np-webdev/Plant-Watering-System/README.md

# Plant-Watering-System

## Pflanzen Bewässerungssystem für 5 Pflanzen

| Arduino, Relaiskarte und Überlaufsensor YL69 |
|-|
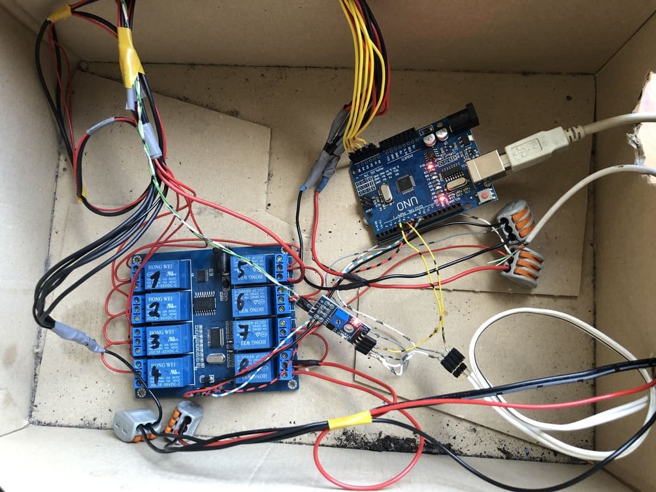
[picture p1: img/1._Arduino,_Relaiskarte_und_Sensor YL69.jpg]
|  |

| Feuchtigkeitssensoren | | | |
|-|-|-|-|
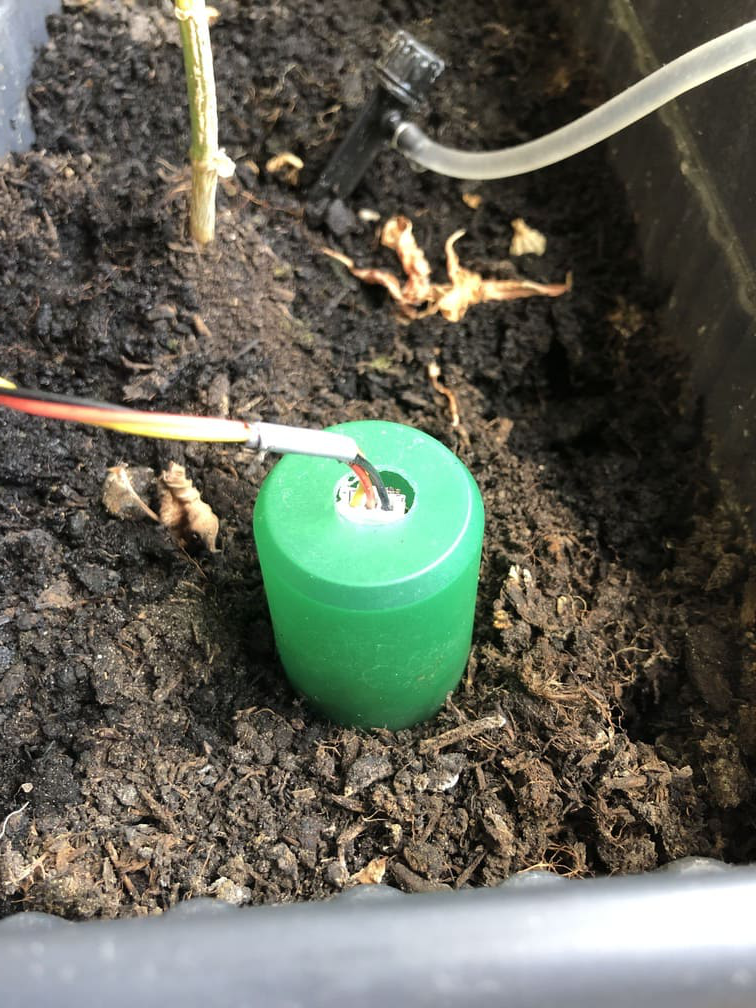
[picture p2: img/2._Feuchtigkeitssensor_verdeckt.jpg]
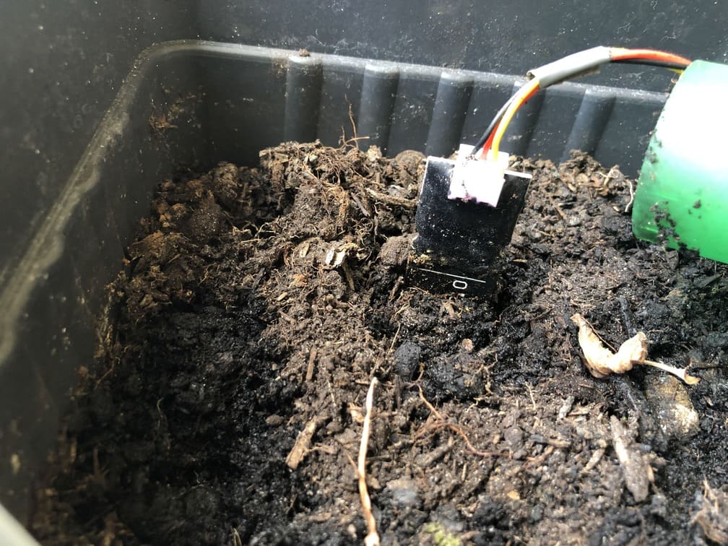
[picture p3: img/3._Feuchtigkeitssensor_mit_heißkleber.jpg]
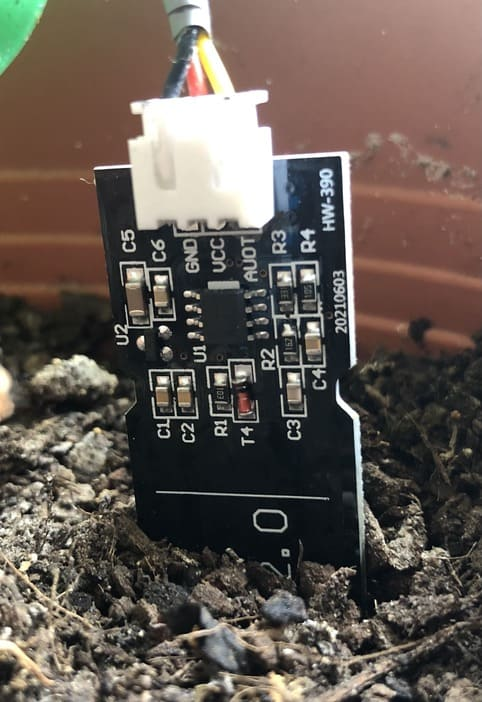
[picture p4: img/3._Feuchtigkeitssensor_neu.jpg]
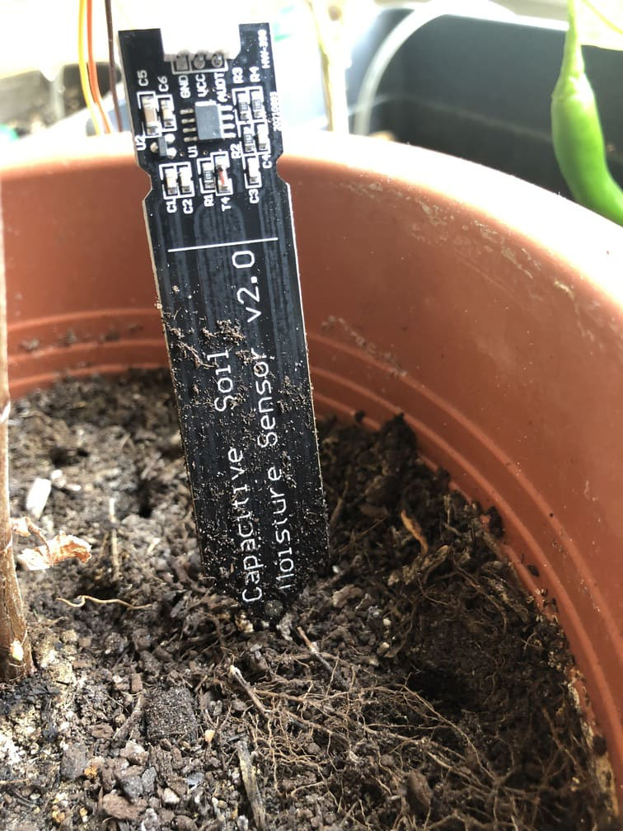
[picture p5: img/3._Feuchtigkeitssensor_neu_komplett.jpg]
|  |  |  |  |

| Pumpe und Schwimmerschalter | Wassertank |
|-|-|
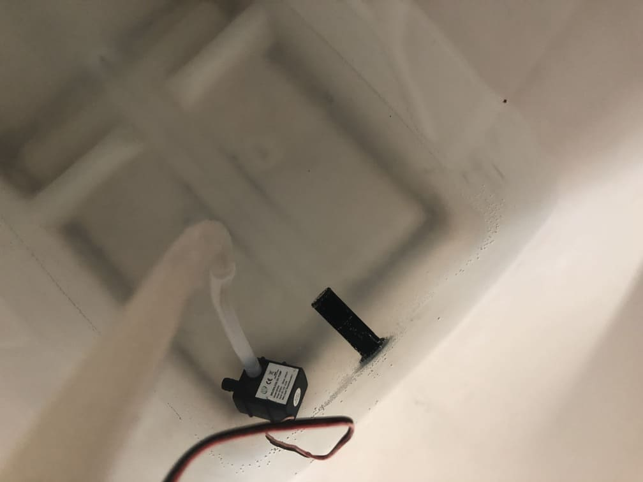
[picture p6: img/4._Tank,_Pumpe,_Schwimmerschalter.jpg]
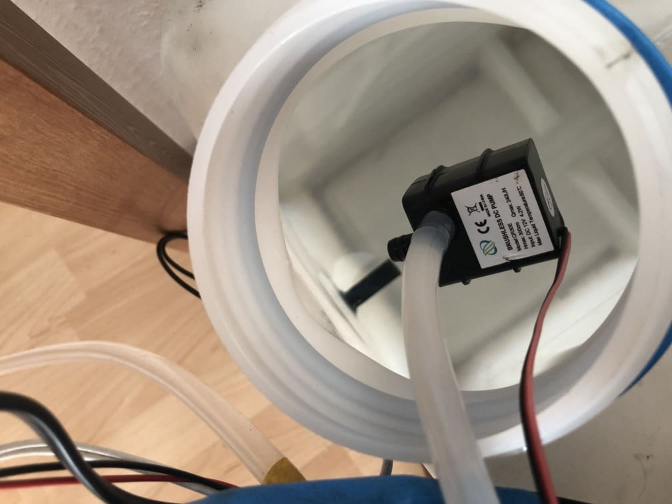
[picture p7: img/4a._Tank,_Pumpe,_Schwimmerschalter.jpg]
|  |  |

| Wasserschläuche mit T-Stücken | Magnetventil | Magnetventil |
|-|-|-|
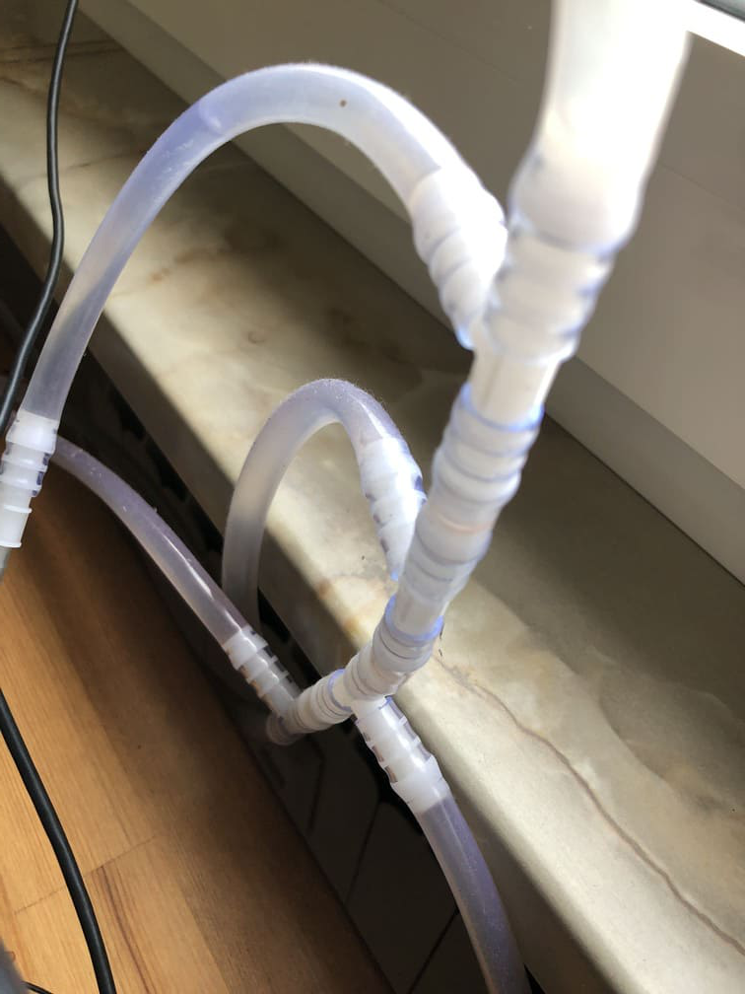
[picture p8: img/5._Schläuche,_T-Stücke.jpg]
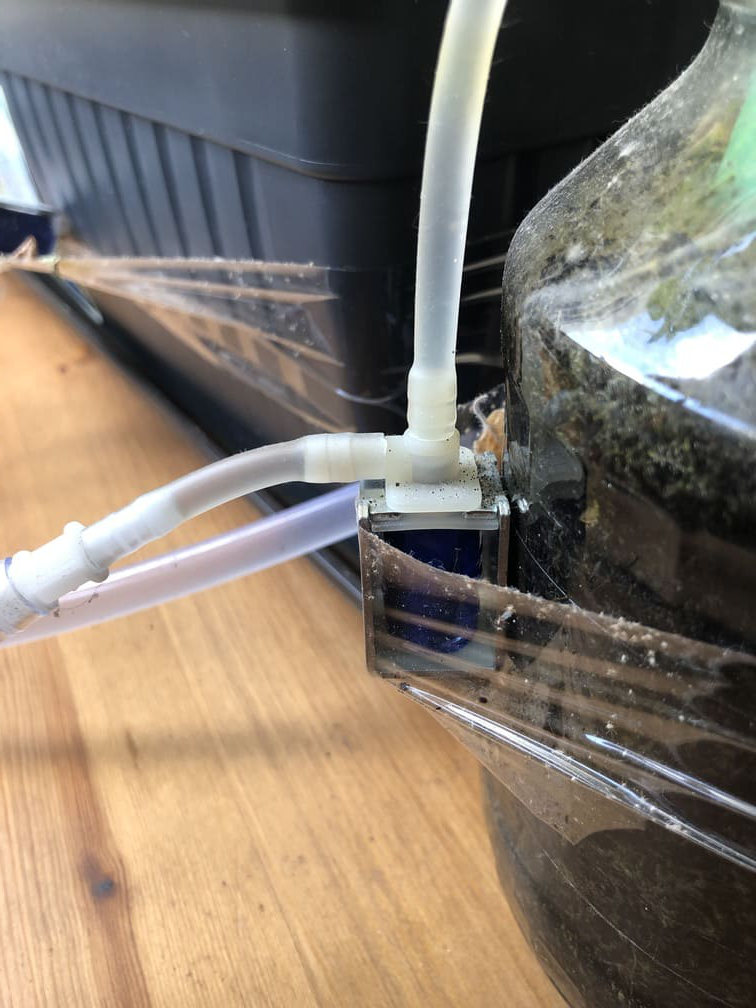
[picture p9: img/6._Magnetventil.jpg]
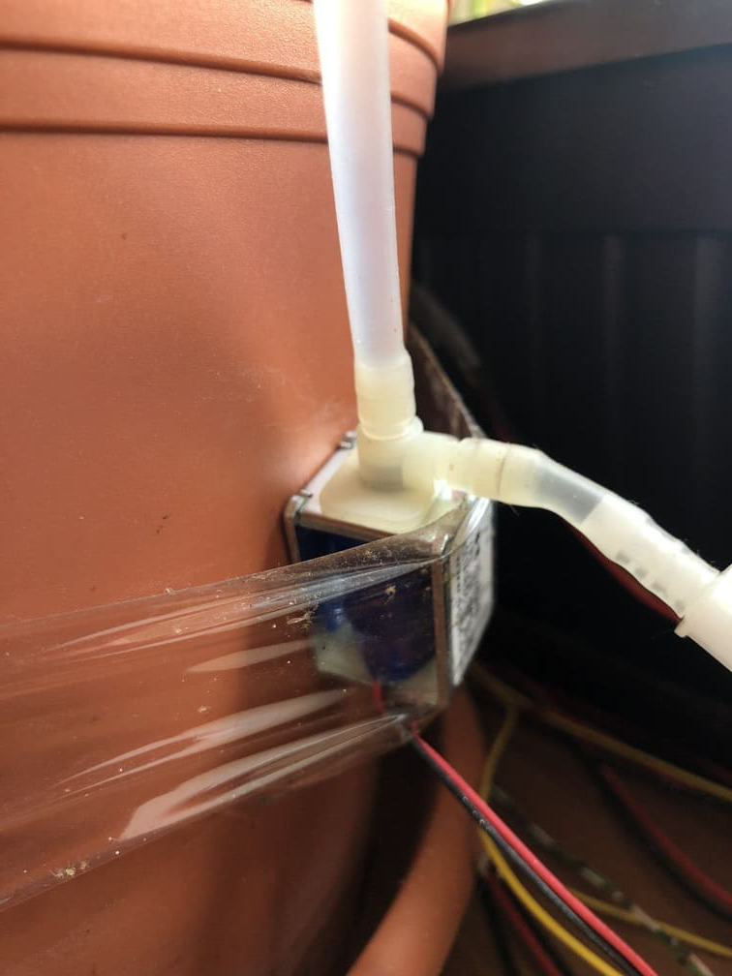
[picture p10: img/7._Magnetventil.jpg]
| |  |  |

| Powerbank | Solarmodul | 12V Netzteil |
|-|-|-|
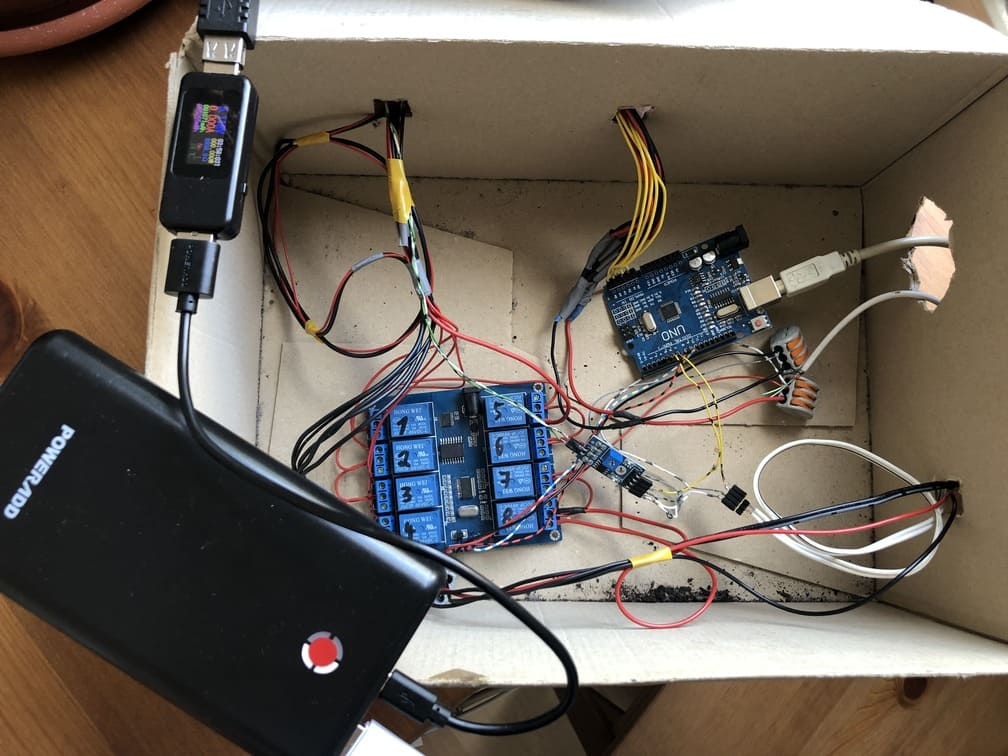
[picture p11: img/8._Powerbank.jpg]
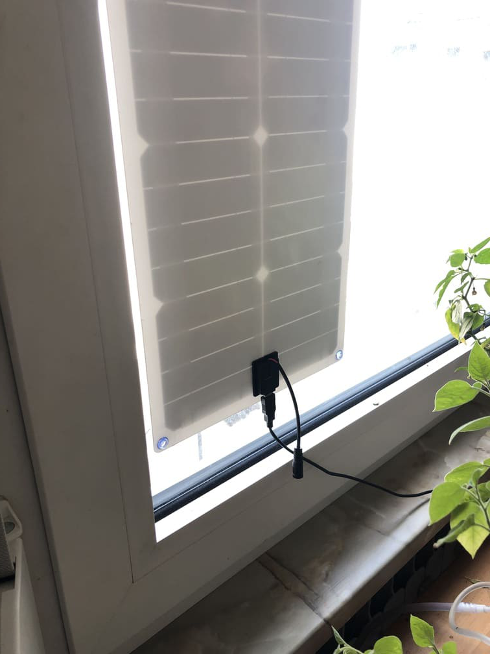
[picture p12: img/9._Solarmodul.jpg]
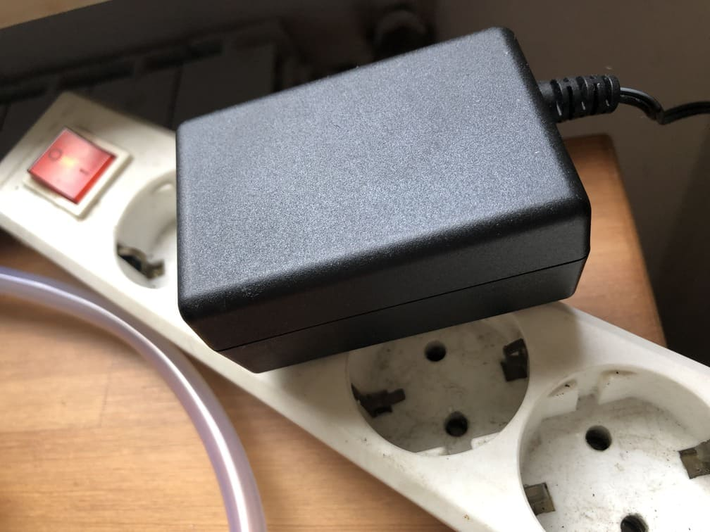
[picture p13: img/10._Netzteil_12V.jpg]
|  |  |  |

| Tropfer | |
|-|-|
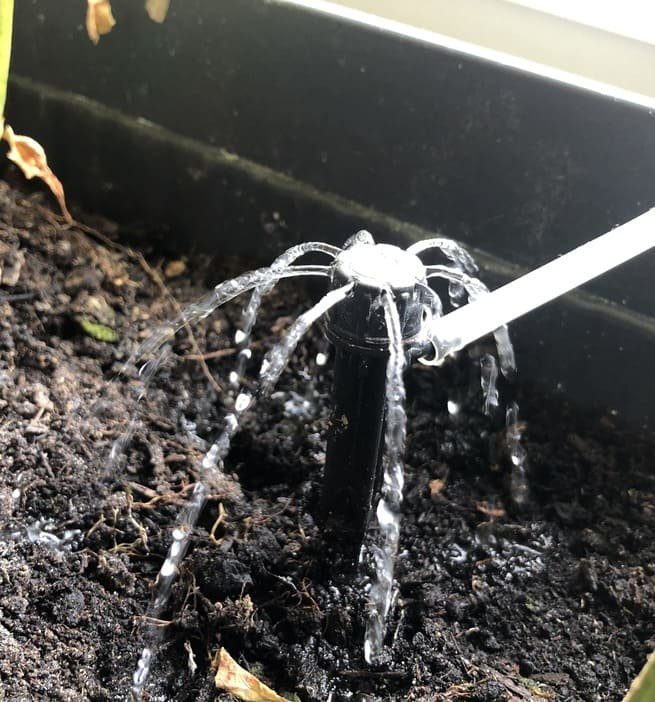
[picture p14: img/Tropfer.jpg]
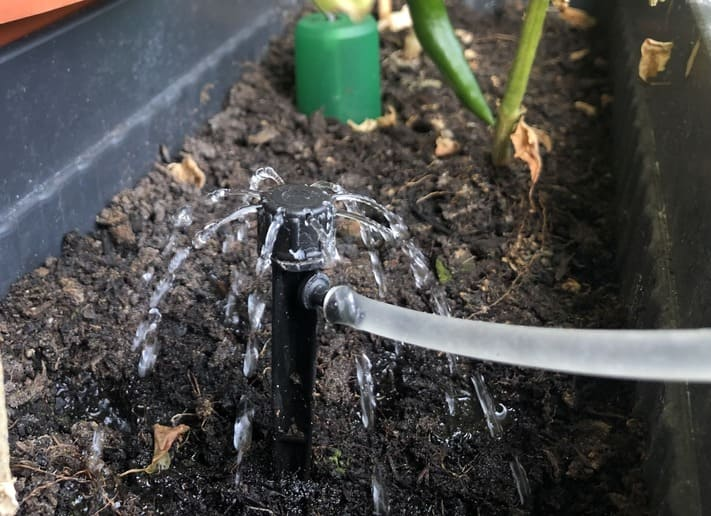
[picture p15: img/Tropfer2.jpg]
|  |  |

<br/>

[Arduino UNO](https://www.ebay.de/itm/144138039161)<br/>
oder<br/>
[Arduino Nano (nicht getestet)](https://www.ebay.de/itm/255283163551)

Pin A1 bis A5 Feuchtigkeitssensoren für die Erde<br/>
[Analog Capacitive Soil Moisture Sensor](https://www.ebay.de/itm/164657628668)

Pin 6 Überlaufsensor<br/>
[YL-69 Feuchtigkeitssensor (nicht perfekt da kabel korrodieren aber bis jetzt keine Alternative)](https://www.ebay.de/itm/203252815145)

Pin 7 Tanküberprüfung<br/>
[Schwimmerschalter, Pegelschalter, Füllstandsschalter, Niveauschalter](https://www.ebay.de/itm/384891203932)

Relaiskarte (diese würde ich nicht empfehlen da die Karte fehlerhaft ist, benötigt aber nur 2 Signalleitungen und Strom)<br/>
[ICStation ICSE014A 8 Channel, Micro USB, DC 5V, 700mA](http://www.icstation.com/icstation-channel-icse014a-micro-switch-relay-module-upper-computer-control-board-icse014a-p-5185.html)
oder
[Alternative Relaiskarte (benötigt 8x output vom Arduino und Strom)](https://www.ebay.de/itm/252355367721)

[Wasserpumpe bürstenlos 12V, 350mA, 4,2W, 240L/h, Hubhöhe 3m, Anschlüsse da = 8mm, Maße lxbxh=55x37x43mm](https://www.ebay.de/itm/353246497633)

[Magnetventile 12V, <160mA, <3W, 0,6Bar, N/C (normaly closed), Anschlüsse da = 4mm](https://www.ebay.de/itm/352962597146)

[StepDown Regler 12V zu 5V, 3A max. USB](https://www.ebay.de/itm/162759316733)
oder
[StepUp Regler 5V zu 12V (fehlerhaft da er überhitzen kann)](https://www.ebay.de/itm/201278090992)

5x Dioden z.B. 1N4004<br/>
(Rote) LED (zeigt leeren Tank und/oder Überlauf an)<br/>
Im Elektroladen oder im Netz

Kabel mit kleinem Querschnitt 0,75mm²?
- ca. 10m Rot (Sensoren, Magnetventile, sonstiges)
- ca. 10m Schwarz (Sensoren, Magnetventile, sonstiges)
- ca. 4m Gelb (Sensorensignal)
- ca. 4m für das Überlaufsensor Kabel

Schläuche
- ca.8m di=4mm<br/>
- ca. 5cm di=8mm für den Anschluss an der Pumpe<br/>
Im Baumarkt oder im Netz kaufen

Schlauchverbinder<br/>
[4x T-Stück 8mm](https://www.ebay.de/itm/311415522853)<br/>
[1x Reduzierungsstück Adapter von 8mm auf 4mm](https://www.ebay.de/itm/311415522853)
  
Kanister min. 15L, Standardisierte Öffnung 48mm, DIN 61 <br/>
Im Baumarkt oder im Netz kaufen
<br/><br/>

Tipps

Elektronik:
- Die Dioden werden unbedingt benötigt da der Arduino sonst von der Selbstinduktionsspannung der Magnetventile einen Stromschlag bekommt (trotz der Relais)
- Arduino, Sensoren und Relaiskarte benötigen 5V. Pumpe und Magnetventile benötigen 12V. Wenn man ein 12V Netzteil oder eine Autobatterie nutzt braucht man einen StepDown regler. Wenn man ein 5V USB Netzteil oder eine Powerbank nutzt braucht man einen StepUp Regler. Man kann auch eine Powerbank/Autobatterie mit einem Solarmodul statt einem Netzteil nutzen um autark zu sein. Es wäre vom Vorteil wenn die Powerbank gleichzeitig laden und entladen kann sonst wird nur gegossen wenn die Sonne nicht scheint.
- Der Arduino Uno hat sechs analoge Eingänge für die Feuchtigkeitssensoren. somit könnte man sechs Pflanzen bewässern. Der Nano müsste mehr haben.
- Die Feuchtigkeitssensoren für die Erde sind nicht ganz präzise und müssten für jede Pflanze selbst eingestellt werden. Wenn die Elektronik des Sensors nass wird meldet er dem Arduino "Trocken" und übergießt die Pflanzen. Daher ist der Überlaufsensor sinnvoll. Bei Benutzung von Tropfern sollte man die Sensoren vor Wasser schützen z.B. alte Deckel in denen man ein Loch für die Kabel bohrt

Schläuche und mehr:
- Länge der Schläuche und Kabel muss jeder für sich berechnen. Wenn die Pflanzen nebeneinander stehen reichen die Längen die ich angegeben habe für fünf Pflanzen.
- Die Schläuche sollten etwas härter sein damit sie nicht knicken.
- Beim Kauf des Kanisters darauf achten dass die Pumpe durch die Öffnung des Kanisters passt. Viele Kanister haben eine standardisierte Öffnung mit 48mm DIN 61. Maße Pumpe LxBxH=55x37x43mm.

<!-- - Die 4mm Schläuche sollten so kurz wie möglich sein da sonst der Druck abfällt.
- Tropfer sehen cool aus aber es geht auch mit dem Schlauch in die Erde. Sollte man auf Tropfer verzichten, kann man ausschließlich 4mm Schläuche nutzen. Auch die T-Stücke müssten dann 4mm sein und es würde nur ein 8mm auf 4mm Reduzierungsstück benötigt werden nach der Pumpe. Dafür bräuchte man allerdings noch ein kurzes Stück Schlauch l=5cm di=8mm oder eine Pumpe mit 4mm Anschluss. -->
<br/><br/>

Preise Stand 08.2022<br/>
| Preis | Artikel |
|-|-|
| 13 | Kanister<br/> |
| 8 | Pume<br/> |
| 30 | Schläuche<br/> |
| 14 | Schlauchverbinder<br/> |
| 30 | 5x Magnetventile<br/> |
| 9 | StepUp Regler (StepDown 3)<br/> |
| 10 | Arduino Uno<br/> |
| 10 | Relaiskarte 8 Kanäle<br/> |
| 7 | 5x Feuchtigkeitssensoren<br/> |
| 3 | Uberlaufsensor<br/> |
| 5 | Tanksensor<br/> |
| 20 | Kabel<br/> |
| | USB Kabel<br/> |
| | USB Hub<br/> |
| 1 | 5x Dioden + LED<br/> |
| | |
| 160€ | Summe |
